ProjectKitchen/Bike-Generator/fotos/BikeGen_foto5.png

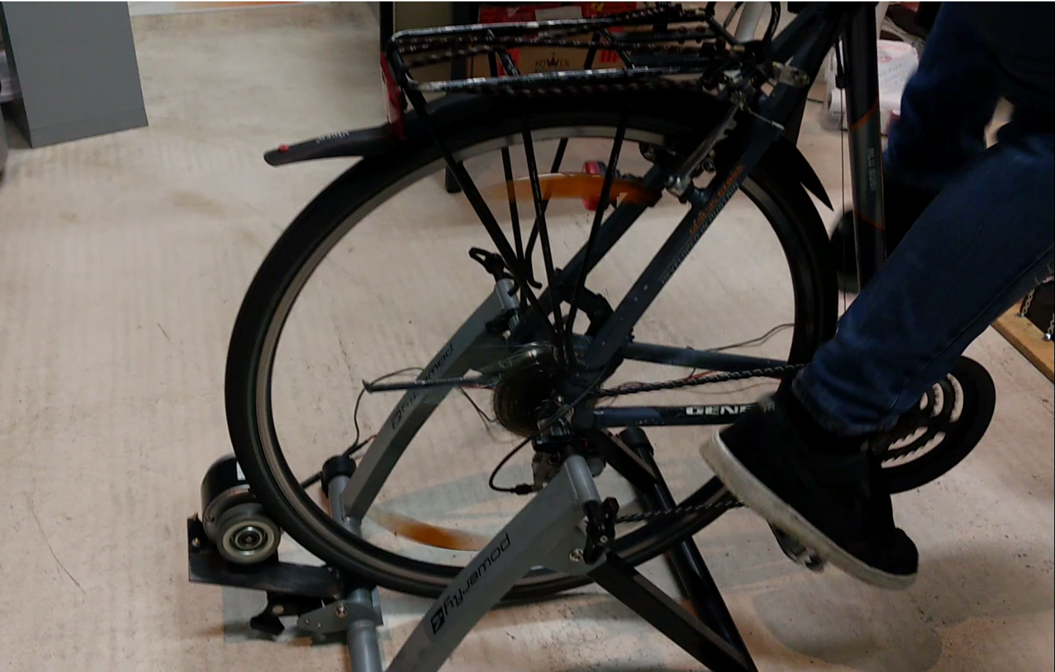
fotos/BikeGen_foto5.png
