ProjectKitchen/Bike-Generator/fotos/BikeGen_foto1.jpg

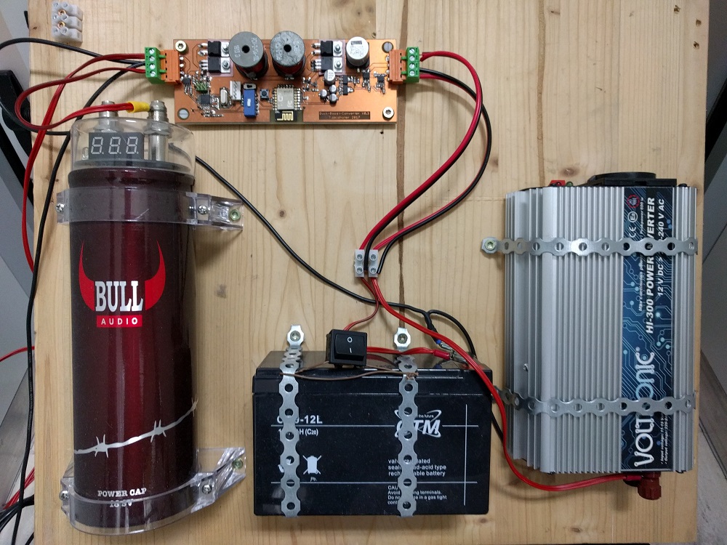
fotos/BikeGen_foto1.jpg
