ProjectKitchen/Bike-Generator/fotos/BikeGen_foto2.png

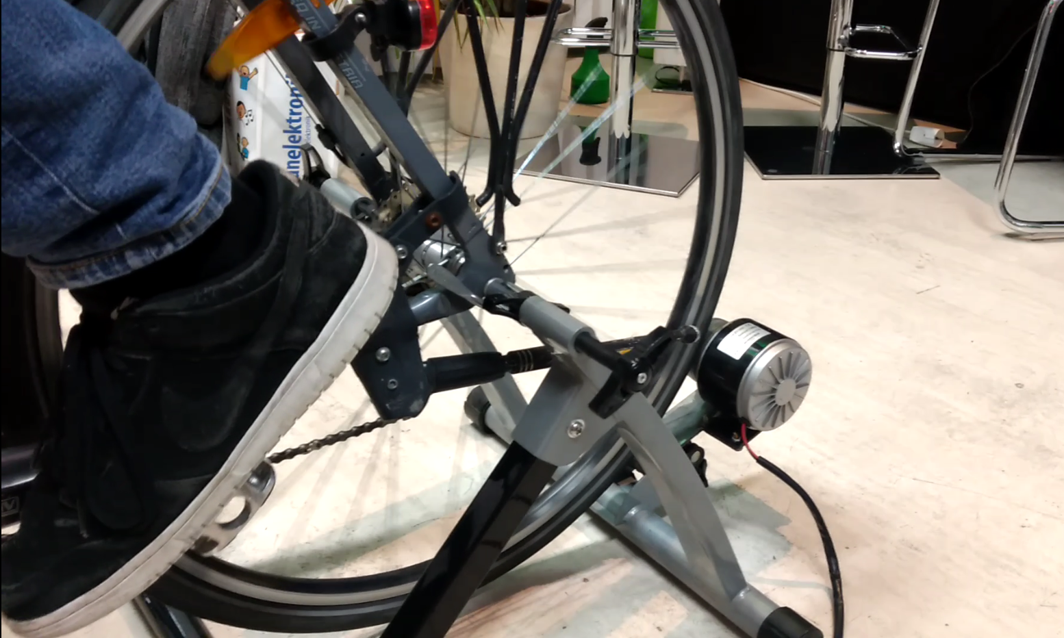
fotos/BikeGen_foto2.png
