ProjectKitchen/Bike-Generator/fotos/BikeGen_foto3.png

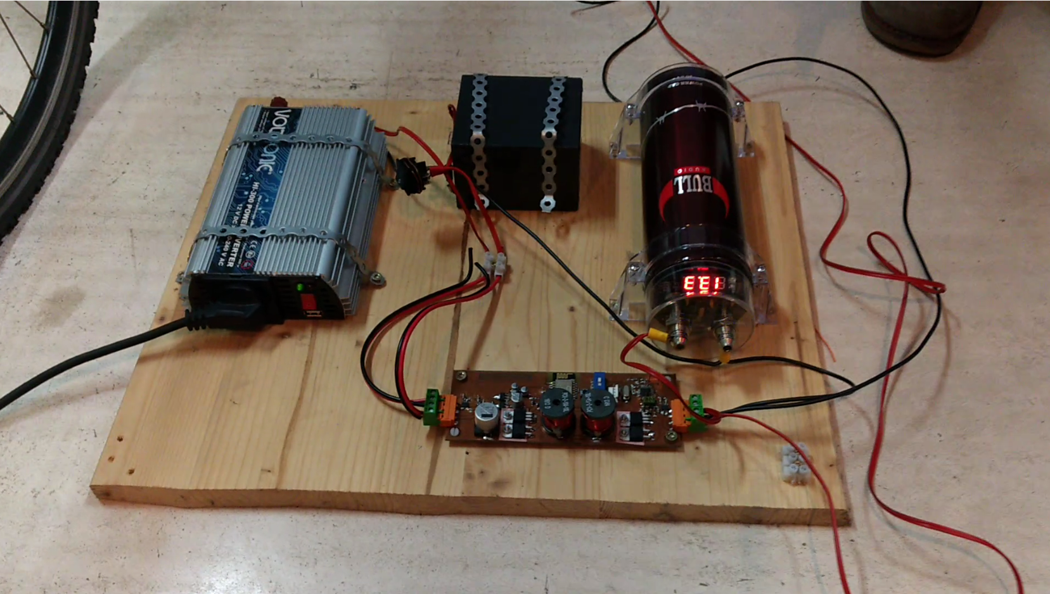
fotos/BikeGen_foto3.png
