ProjectKitchen/Bike-Generator/fotos/BikeGen_foto4.png

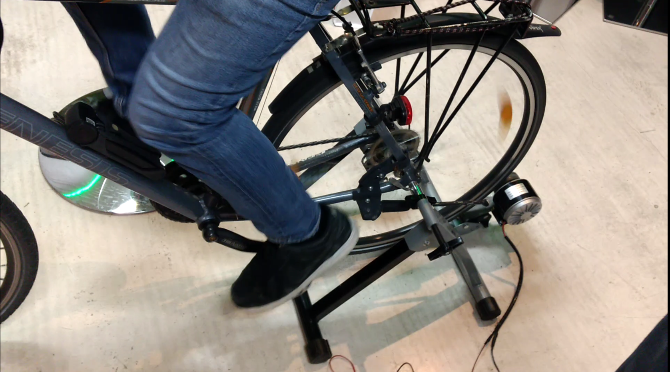
fotos/BikeGen_foto4.png
