ProjectKitchen/Bike-Generator/fotos/BikeGen_foto6.png

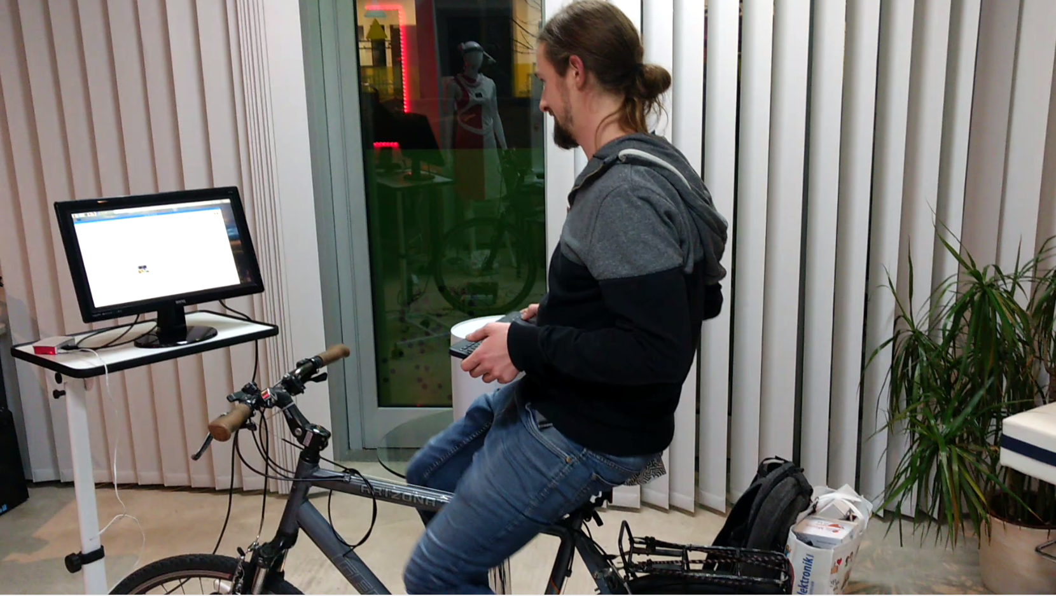
fotos/BikeGen_foto6.png
