ProjectKitchen/Bike-Generator/fotos/BikeGen_foto7.png

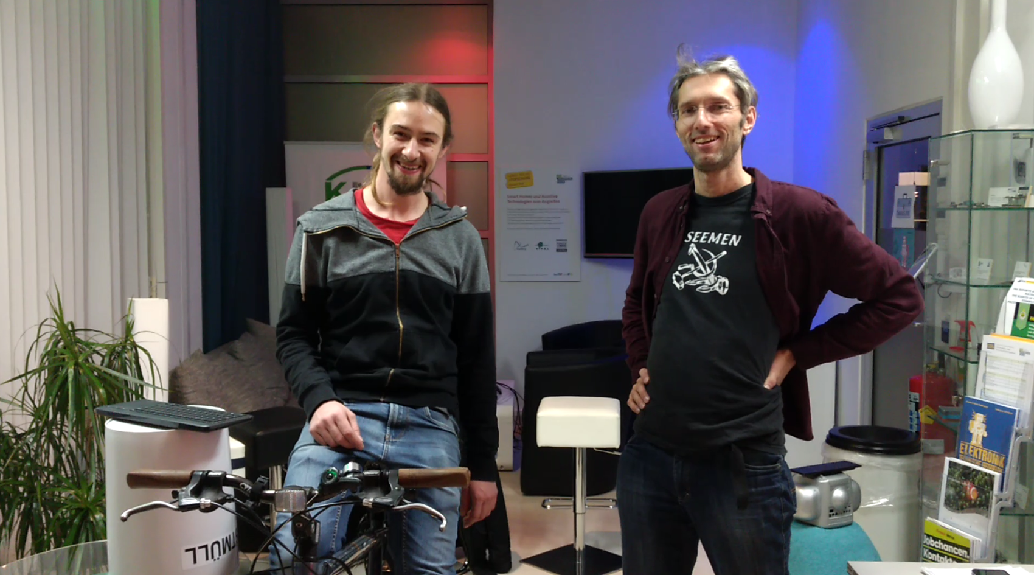
fotos/BikeGen_foto7.png
