ProjectKitchen/Bike-Generator/fotos/bull_2F_capacitor.jpg

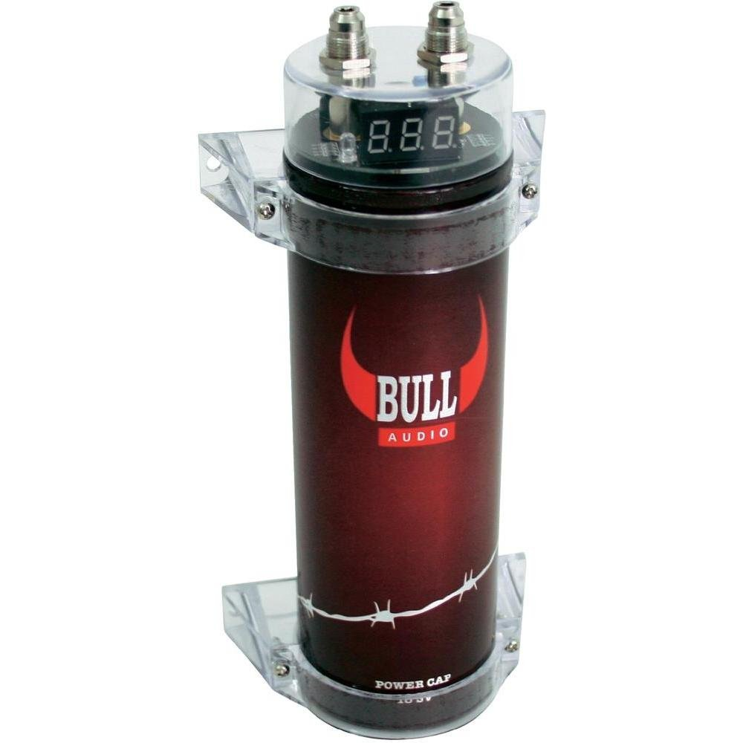
fotos/bull_2F_capacitor.jpg
