ProjectKitchen/Bike-Generator/fotos/MYZ016 ZY1016 Elektromotor DC 24V 200 W.jpg

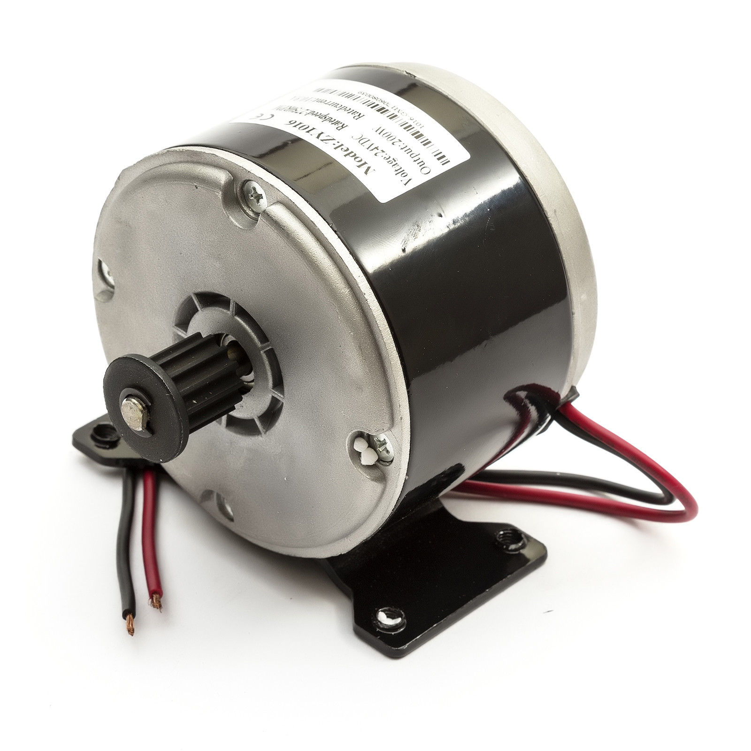
fotos/MYZ016 ZY1016 Elektromotor DC 24V 200 W.jpg
