ProjectKitchen/Bike-Generator/fotos/powerfly_magnetic_rollentrainer.jpg

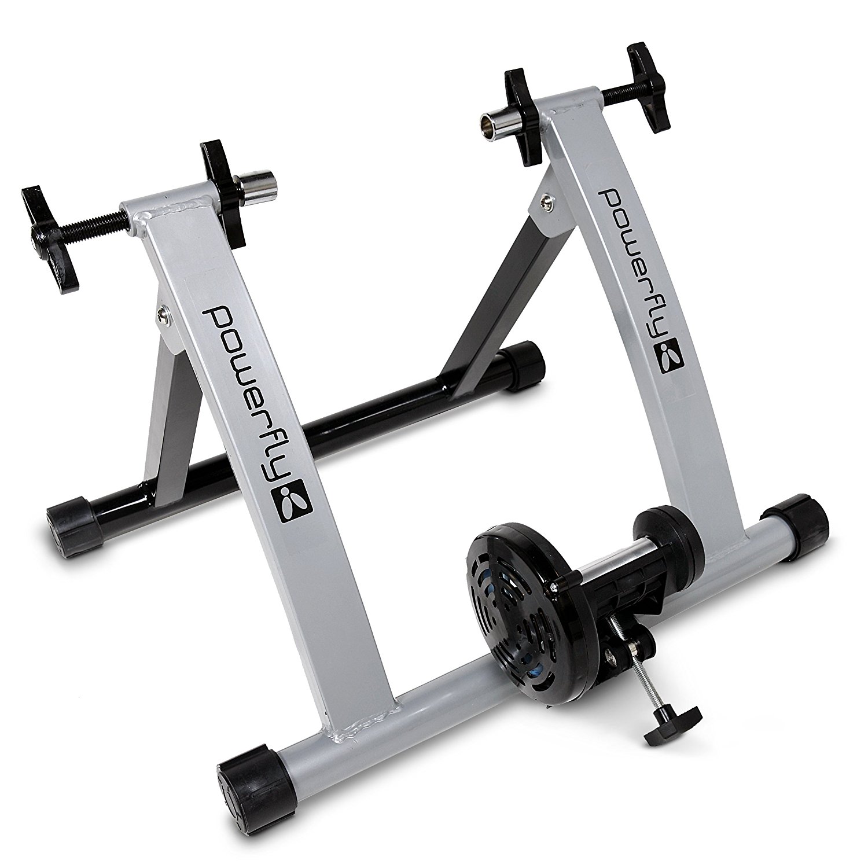
fotos/powerfly_magnetic_rollentrainer.jpg
