ProjectKitchen/Bike-Generator/fotos/voltronic_300W_inverterjpg.jpg

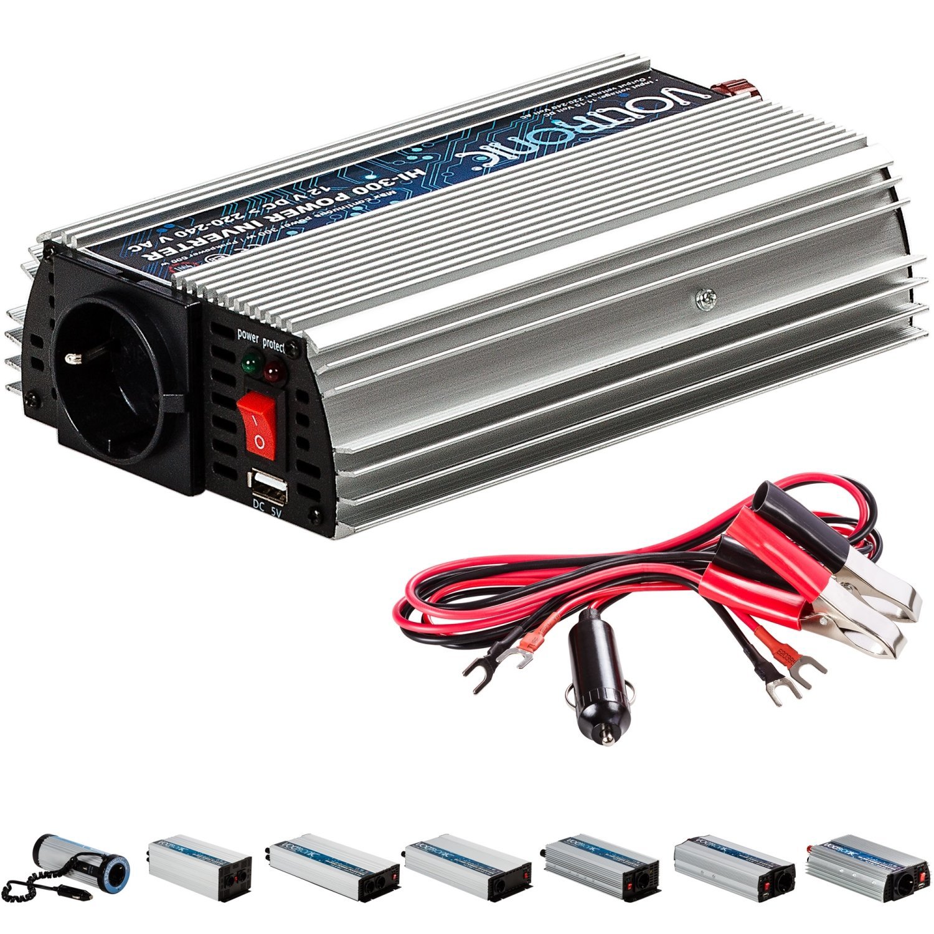
fotos/voltronic_300W_inverterjpg.jpg
