ProjectKitchen/Bike-Generator/BOM.txt

MYZ016 ZY1016 DC Motor 24V 200W (ebay)                      30 €
Bull 2F Capacitor               (amazon)                    29 €
Voltronic 300W Inverter         (amazon)                    35 €
Powerfly Magnetic Bike Trainer  (amazon)                    42 €
12V LeadScid Gel Battery                                    15 €
Components for buck/boost converter  (see bachelor paper)   58 €
wood, cables, etc.                                           5 €
                                                          ------
								                           214 €
