ProjectKitchen/Bike-Generator/PCB-Eagle/Final_Farnell_orderlist.xlsx

Sheet: Sheet1
Part Number | Quantity
1081224 | 4
1329624 | 3
1462952 | 1
1469076 | 1
1715486 | 1
1759195 | 2
1759265 | 6
2320018 | 1
2395958 | 1
2447553 | 5
2447654 | 3
2464030 | 2
2527545 | 4
2543088 | 1
2611384 | 3
2611386 | 1
2630479 | 1
9406344 | 3
9778314 | 1
9803351 | 2
9846530 | 2

Sheet: Sheet2
Part Number | Quantity | Description
62X6560 | 1 | Raspberry Pi

Sheet: Sheet3
Part Number | Quantity | Description
62X6560 | 1 | Raspberry Pi
