ProjectKitchen/Bike-Generator/PCB-Eagle/partslist1 (tobis-PC's conflicted copy 2017-02-14).xlsx

Sheet: partslist_THT
Part | Value | Device | Package | Library | Price(1+) | Price(10+) | cheaper | link
AMMETER1 | ACS712ELCTR-20A-T | ACS712ELCTR-20A-T | SOIC127P600X175-8N | ACS712-20A_Farnell | 4.310 | 2.480 | 2.480 | http://at.farnell.com/allegro-microsystems/acs712elctr-20a-t/sensor-strom-20a-soic8-712/dp/1329624
AMMETER2 | ACS712ELCTR-20A-T | ACS712ELCTR-20A-T | SOIC127P600X175-8N | ACS712-20A_Farnell | 4.310 | 2.480 | 2.480 | http://at.farnell.com/allegro-microsystems/acs712elctr-20a-t/sensor-strom-20a-soic8-712/dp/1329624
AMMETER3 | ACS712ELCTR-20A-T | ACS712ELCTR-20A-T | SOIC127P600X175-8N | ACS712-20A_Farnell | 4.310 | 2.480 | 2.480 | http://at.farnell.com/allegro-microsystems/acs712elctr-20a-t/sensor-strom-20a-soic8-712/dp/1329624
BIKE_INPUT |  | PINHD-1X2 | 1X02 | pinhead | 0.170 | 0.153 | 0.153 | http://at.farnell.com/camdenboss/ctbp3051-2/klemmenblock-wire-to-board-2pos/dp/2527545
C1 | 22pF | C-EU025-024X044 | C025-024X044 | rcl |  | 0.206 | 0.206 | http://at.farnell.com/vishay/k220j15c0gf53l2/kond-mlcc-c0g-np0-22pf-50v-radial/dp/1141760
C2 | 22pF | C-EU025-024X044 | C025-024X044 | rcl |  | 0.206 | 0.206 | http://at.farnell.com/vishay/k220j15c0gf53l2/kond-mlcc-c0g-np0-22pf-50v-radial/dp/1141760
C3 | 1000uF | CPOL-EUE5-10,5 | E5-10,5 | rcl |  | 0.603 | 0.603 | http://at.farnell.com/panasonic-electronic-components/eca-1ehg102/kondensator-alu-elko-1000uf-25v/dp/1848543
C4 | 22uF | CPOL-EUE2-5 | E2-5 | rcl | 0.050 |  | 0.050 | http://at.farnell.com/multicomp/mcgpr16v226m5x11/alu-elko-22uf-16v-radial/dp/9451064
C5 | 22uF | CPOL-EUE2-5 | E2-5 | rcl | 0.050 |  | 0.050 | http://at.farnell.com/multicomp/mcgpr16v226m5x11/alu-elko-22uf-16v-radial/dp/9451064
C6 | 1nF | C-EU025-024X044 | C025-024X044 | rcl |  | 0.038 | 0.038 | http://at.farnell.com/multicomp/mcbu5102k5/kondensator-mlcc-y5p-1nf-50v-radial/dp/9411780
C7 | 100nF | C-EU025-024X044 | C025-024X044 | rcl |  | 0.073 | 0.073 | http://at.farnell.com/vishay/k104k15x7rf53l2/kondensator-mlcc-x7r-100nf-50v/dp/1141775
C8 | 100nF | C-EU025-025X050 | C025-025X050 | rcl |  | 0.073 | 0.073 | http://at.farnell.com/vishay/k104k15x7rf53l2/kondensator-mlcc-x7r-100nf-50v/dp/1141775
C9 | 1nF | C-EU025-024X044 | C025-024X044 | rcl |  | 0.038 | 0.038 | http://at.farnell.com/multicomp/mcbu5102k5/kondensator-mlcc-y5p-1nf-50v-radial/dp/9411780
C10 | 1nF | C-EU025-024X044 | C025-024X044 | rcl |  | 0.038 | 0.038 | http://at.farnell.com/multicomp/mcbu5102k5/kondensator-mlcc-y5p-1nf-50v-radial/dp/9411780
C11 | 100nF | C-EU025-024X044 | C025-024X044 | rcl |  | 0.073 | 0.073 | http://at.farnell.com/vishay/k104k15x7rf53l2/kondensator-mlcc-x7r-100nf-50v/dp/1141775
C12 | 22uF | CPOL-EUE2-5 | E2-5 | rcl | 0.050 |  | 0.050 | http://at.farnell.com/multicomp/mcgpr16v226m5x11/alu-elko-22uf-16v-radial/dp/9451064
C14 | 220uF | CPOL-EUE3.5-8 | E3,5-8 | rcl | 0.119 |  | 0.119 | http://at.farnell.com/multicomp/mcgpr25v227m8x11/alu-elko-220uf-25v-radial/dp/9451196
D1 |  | STPS1045 | TO220AC | stps1045_own | 0.774 |  | 0.774 | http://at.farnell.com/stmicroelectronics/stps1045d/schottky-diode-10a-45v/dp/9803351?exaMfpn=true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
D2 |  | STPS1045 | TO220AC | stps1045_own | 0.774 |  | 0.774 | http://at.farnell.com/stmicroelectronics/stps1045d/schottky-diode-10a-45v/dp/9803351?exaMfpn=true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
D3 | GPA1603 | DIODE-C221B1A | C221B1A | diode | ??? |  | ???
EXTERNAL_CAP |  | PINHD-1X2 | 1X02 | pinhead | 0.170 | 0.153 | 0.153 | http://at.farnell.com/camdenboss/ctbp3051-2/klemmenblock-wire-to-board-2pos/dp/2527545
IC1 | MEGA8-P | MEGA8-P | DIL28-3 | atmel | 3.330 |  | 3.330 | http://at.farnell.com/atmel/atmega328p-pu/mcu-8bit-avr-32k-flash-28pdip/dp/1715487
IC2 | LD117AV33 | LD117AV33 | TO220L1 | v-reg | 0.397 |  | 0.397 | http://at.farnell.com/stmicroelectronics/ld1117v33c/spannungsregler/dp/1703357
IC3 | LD117AV50 | LD117AV50 | TO220L1 | v-reg | 0.624 |  | 0.624 | http://at.farnell.com/stmicroelectronics/ld1117v50/v-reg-ldo-5-0v-1117-to220-3/dp/1087175
L1 |  | L-EUTJ4-U2 | TJ4-U2 | rcl | 5.220 |  | 5.220 | http://at.farnell.com/coilcraft/pcv-2-104-10l/leistungsinduktivit-t-100uh-10/dp/2457690?exaMfpn=true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
L2 |  | L-EUTJ4-U2 | TJ4-U2 | rcl | 5.220 |  | 5.220 | or | http://at.farnell.com/coilcraft/pcv-2-184-10l/leistungsinduktivit-t-180uh-8a/dp/2457692?exaMfpn=true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
Q2 | 16Mhz | CRYSTALHC49U70 | HC49U70 | crystal | 0.182 |  | 0.182 | http://at.farnell.com/qantek-technology-corporation/qcl16-0000f18b23b/quarz-16mhz-18pf-hc-49us/dp/2508458
R1 | 10k Ohm | R-EU_0207/10 | 0207/10 | resistor |  | 0.0317 | 0.032 | http://at.farnell.com/te-connectivity/cfr25j10k/kohleschichtwiderstand-10k-0-33w/dp/2329609
R2 | 1kR | R-EU_0207/10 | 0207/10 | resistor |  | 0.0492 | 0.049 | http://at.farnell.com/te-connectivity/lr1f1k0/metallschichtwiderstand-1k0-0/dp/2330035
R3 | 390R | R-EU_0207/10 | 0207/10 | resistor |  | 0.0554 | 0.055 | http://at.farnell.com/multicomp/mcmf006ff3900a50/metallschichtwiderstand-390r-1/dp/2401742
R4 | 1k R | R-EU_0207/10 | 0207/10 | resistor |  | 0.0492 | 0.049 | http://at.farnell.com/te-connectivity/lr1f1k0/metallschichtwiderstand-1k0-0/dp/2330035
R5 | 390R | R-EU_0207/10 | 0207/10 | resistor |  | 0.0554 | 0.055 | http://at.farnell.com/multicomp/mcmf006ff3900a50/metallschichtwiderstand-390r-1/dp/2401742
R6 | 1k R | R-EU_0207/10 | 0207/10 | resistor |  | 0.0492 | 0.049 | http://at.farnell.com/te-connectivity/lr1f1k0/metallschichtwiderstand-1k0-0/dp/2330035
R7 | 390R | R-EU_0207/10 | 0207/10 | resistor |  | 0.0554 | 0.055 | http://at.farnell.com/multicomp/mcmf006ff3900a50/metallschichtwiderstand-390r-1/dp/2401742
R9 | 10k Ohm | R-EU_0207/10 | 0207/10 | resistor |  | 0.0317 | 0.032 | http://at.farnell.com/te-connectivity/cfr25j10k/kohleschichtwiderstand-10k-0-33w/dp/2329609
T1 | SUP65P06-20 | SUP65P06-20 | TO220 | transistor-fet | 1.13 |  | 1.130 | http://at.farnell.com/fairchild-semiconductor/fqp27p06/mosfet-p-kanal-60v-27a-to-220/dp/9846530
T2 | SUP65P06-20 | SUP65P06-20 | TO220 | transistor-fet | 1.13 |  | 1.130 | http://at.farnell.com/fairchild-semiconductor/fqp27p06/mosfet-p-kanal-60v-27a-to-220/dp/9846530
T3 | BC33725BU | BC337-25-NPN-TO92-CBE | TO92-CBE | transistor |  | 0.173 | 0.173 | http://at.farnell.com/fairchild-semiconductor/bc33725bu/transistor-npn-45v-to-92-3-straight/dp/2453781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
T4 | BC33725BU | BC337-25-NPN-TO92-CBE | TO92-CBE | transistor |  | 0.173 | 0.173 | http://at.farnell.com/fairchild-semiconductor/bc33725bu/transistor-npn-45v-to-92-3-straight/dp/2453781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
T5 | BC32740TA | BC327-40 | TO92-EBC | transistor-pnp |  | 0.077 | 0.077 | http://at.farnell.com/fairchild-semiconductor/bc32740ta/transistor-bipolar-pnp-45v-to/dp/2453778
T6 | BC33725BU | BC337-25-NPN-TO92-CBE | TO92-CBE | transistor |  | 0.173 | 0.173 | http://at.farnell.com/fairchild-semiconductor/bc33725bu/transistor-npn-45v-to-92-3-straight/dp/2453781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
T7 | BC33725BU | BC337-25-NPN-TO92-CBE | TO92-CBE | transistor |  | 0.173 | 0.173 | http://at.farnell.com/fairchild-semiconductor/bc33725bu/transistor-npn-45v-to-92-3-straight/dp/2453781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
T8 | BC32740TA | BC327-40 | TO92-EBC | transistor-pnp |  | 0.077 | 0.077 | http://at.farnell.com/fairchild-semiconductor/bc32740ta/transistor-bipolar-pnp-45v-to/dp/2453778
TO_BATTERY |  | PINHD-1X2 | 1X02 | pinhead | 0.170 | 0.153 | 0.153 | http://at.farnell.com/camdenboss/ctbp3051-2/klemmenblock-wire-to-board-2pos/dp/2527545
TO_RECTIFIER |  | PINHD-1X2 | 1X02 | pinhead | 0.170 | 0.153 | 0.153 | http://at.farnell.com/camdenboss/ctbp3051-2/klemmenblock-wire-to-board-2pos/dp/2527545
U$1 | JS202011CQN-DPDT | JS202011CQN-DPDT | 2X3_SWITCH | Library_TW | 0.394 |  | 0.394 | http://at.farnell.com/c-k-components/js202011cqn/schalter-dpdt-0-6a-6vdc-tht/dp/2320018?ost=JS202011CQN-DPDT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
U$2 | SPC21205-4PDT | SPC21205-4PDT | 2X6_SWITCH | Library_TW | 1.780 |  | 1.780 | http://at.farnell.com/multicomp/spc21205/schiebeschalter-4pdt-0-3a-125v/dp/2543088
U1 | ESP01 | ESP01 | ESP01 | esp8266modules | 6.490 |  | 6.490 | http://www.digikey.at/product-detail/en/sparkfun-electronics/WRL-13678/1568-1235-ND/5725944
U2 | ESP-07 or 12 | ESP12ESMD | ESP12E-SMD | esp8266modules |  |  | 0.000
USB-PROGRAMMER |  | PINHD-1X5 | 1X05 | pinhead | 0.128 |  | 0.128 | http://at.farnell.com/molex/22-23-2051/stecker-pin-5kont/dp/1462952
PCB-RAW_MATERIAL |  |  |  |  |  |  | 7.580 | http://at.farnell.com/kelan/141301/leiterplatte-fotopositivlack-100x160/dp/141301
 |  |  |  |  |  | Total: | 46.044

Sheet: parslist_SMD
Part | Value | Device | Package | Library | Price(1+) | Price(10+) | link
AMMETER1 | ACS712ELCTR-20A-T | ACS712ELCTR-20A-T | SOIC127P600X175-8N | ACS712-20A_Farnell
AMMETER2 | ACS712ELCTR-20A-T | ACS712ELCTR-20A-T | SOIC127P600X175-8N | ACS712-20A_Farnell
AMMETER3 | ACS712ELCTR-20A-T | ACS712ELCTR-20A-T | SOIC127P600X175-8N | ACS712-20A_Farnell
BIKE_INPUT |  | PINHD-1X2 | 1X02 | pinhead
C1 | 22pF | C-EU025-024X044 | C025-024X044 | rcl |  | 0.0049 | http://at.farnell.com/multicomp/mc0402n220j500ct/kondensator-mlcc-c0g-np0-22pf/dp/1758951
C2 | 22pF | C-EU025-024X044 | C025-024X044 | rcl |  | 0.0049 | http://at.farnell.com/multicomp/mc0402n220j500ct/kondensator-mlcc-c0g-np0-22pf/dp/1758951
C3 |  | CPOL-EUE3.5-8 | E3,5-8 | rcl
C4 | 22uF | CPOL-EUE1.8-4 | E1,8-4 | rcl
C5 | 22uF | CPOL-EUE1.8-4 | E1,8-4 | rcl
C6 | 1nF | C-EU025-024X044 | C025-024X044 | rcl |  | 0.0039 | http://at.farnell.com/multicomp/mc0402b102k500ct/kondensator-mlcc-x7r-1nf-50v-0402/dp/1758991
C7 | 100nF | C-EU025-024X044 | C025-024X044 | rcl |  | 0.0039 | http://at.farnell.com/multicomp/mc0402b104k100ct/kondensator-mlcc-x7r-0-1uf-10v/dp/2627343
C8 | 100nF | C-EU025-025X050 | C025-025X050 | rcl |  | 0.0039 | http://at.farnell.com/multicomp/mc0402b104k100ct/kondensator-mlcc-x7r-0-1uf-10v/dp/2627343
C9 | 1nF | C-EU025-024X044 | C025-024X044 | rcl |  | 0.0039 | http://at.farnell.com/multicomp/mc0402b102k500ct/kondensator-mlcc-x7r-1nf-50v-0402/dp/1758991
C10 | 1nF | C-EU025-024X044 | C025-024X044 | rcl |  | 0.0039 | http://at.farnell.com/multicomp/mc0402b102k500ct/kondensator-mlcc-x7r-1nf-50v-0402/dp/1758991
C11 | 100nF | C-EU025-024X044 | C025-024X044 | rcl |  | 0.0039 | http://at.farnell.com/multicomp/mc0402b104k100ct/kondensator-mlcc-x7r-0-1uf-10v/dp/2627343
C12 |  | CPOL-EUE3.5-8 | E3,5-8 | rcl
C14 |  | CPOL-EUE3.5-8 | E3,5-8 | rcl
D1 |  | STPS1045 | TO220AC | stps1045_own
D2 |  | STPS1045 | TO220AC | stps1045_own
D3 | GPA1603 | DIODE-C221B1A | C221B1A | diode
EXTERNAL_CAP |  | PINHD-1X2 | 1X02 | pinhead
IC1 | MEGA8-P | MEGA8-P | DIL28-3 | atmel | 2.79 |  | http://at.farnell.com/atmel/atmega328p-au/mcu-8bit-avr-32k-flash-32tqfp/dp/1715486
IC2 | LD117AV33 | LD117AV33 | TO220L1 | v-reg
IC3 | LD117AV50 | LD117AV50 | TO220L1 | v-reg
L1 |  | L-EUTJ4-U2 | TJ4-U2 | rcl
L2 |  | L-EUTJ4-U2 | TJ4-U2 | rcl
Q2 | 16Mhz | CRYSTALHC49U70 | HC49U70 | crystal | 0.192 |  | http://at.farnell.com/multicomp/mcrsd16000f183000rr/crystal-16mhz-18pf-hc49-us-smd/dp/2395958
R1 | 10k Ohm | R-EU_0207/10 | 0207/10 | resistor |  | 0.0012 | http://at.farnell.com/multicomp/mc0063w0603110k/dickschichtwiderstand-10k-1-0/dp/9330399
R2 | 1kR | R-EU_0207/10 | 0207/10 | resistor |  | 0.0704 | http://at.farnell.com/te-connectivity/crgh1206f1k0/dickschichtwiderstand-1k-1-0-5w/dp/2332141
R3 | 390R | R-EU_0207/10 | 0207/10 | resistor |  | 0.0948 | http://at.farnell.com/te-connectivity/crgh1206f390r/dickschichtwiderstand-390r-1-0/dp/2332134
R4 | 1k R | R-EU_0207/10 | 0207/10 | resistor |  | 0.0704 | http://at.farnell.com/te-connectivity/crgh1206f1k0/dickschichtwiderstand-1k-1-0-5w/dp/2332141
R5 | 390R | R-EU_0207/10 | 0207/10 | resistor |  | 0.0948 | http://at.farnell.com/te-connectivity/crgh1206f390r/dickschichtwiderstand-390r-1-0/dp/2332134
R6 | 1k R | R-EU_0207/10 | 0207/10 | resistor |  | 0.0704 | http://at.farnell.com/te-connectivity/crgh1206f1k0/dickschichtwiderstand-1k-1-0-5w/dp/2332141
R7 | 390R | R-EU_0207/10 | 0207/10 | resistor |  | 0.0948 | http://at.farnell.com/te-connectivity/crgh1206f390r/dickschichtwiderstand-390r-1-0/dp/2332134
R9 | 10k Ohm | R-EU_0207/10 | 0207/10 | resistor |  | 0.0012 | http://at.farnell.com/multicomp/mc0063w0603110k/dickschichtwiderstand-10k-1-0/dp/9330399
T1 | SUP65P06-20 | SUP65P06-20 | TO220 | transistor-fet
T2 | SUP65P06-20 | SUP65P06-20 | TO220 | transistor-fet
T3 | BC337-25 | BC337-25-NPN-TO92-CBE | TO92-CBE | transistor
T4 | BC337-25 | BC337-25-NPN-TO92-CBE | TO92-CBE | transistor
T5 | BC327-40 | BC327-40 | TO92-EBC | transistor-pnp
T6 | BC337-25 | BC337-25-NPN-TO92-CBE | TO92-CBE | transistor
T7 | BC337-25 | BC337-25-NPN-TO92-CBE | TO92-CBE | transistor
T8 | BC327-40 | BC327-40 | TO92-EBC | transistor-pnp
TO_BATTERY |  | PINHD-1X2 | 1X02 | pinhead
TO_RECTIFIER |  | PINHD-1X2 | 1X02 | pinhead
U$1 | JS202011CQN-DPDT | JS202011CQN-DPDT | 2X3_SWITCH | Library_TW
U$2 | SPC21205-4PDT | SPC21205-4PDT | 2X6_SWITCH | Library_TW
U1 | ESP01 | ESP01 | ESP01 | esp8266modules
U2 | ESP-07 or 12 | ESP12ESMD | ESP12E-SMD | esp8266modules
USB-PROGRAMMER |  | PINHD-1X5 | 1X05 | pinhead

Sheet: Partslist_Final
Part | Value | Device | Package | Library | Price(1+) | Price(10+) | link
AMMETER1 | ACS712ELCTR-20A-T | ACS712ELCTR-20A-T | SOIC127P600X175-8N | ACS712-20A_Farnell | 4.31 | 2.48 | http://at.farnell.com/allegro-microsystems/acs712elctr-20a-t/sensor-strom-20a-soic8-712/dp/1329624
AMMETER2 | ACS712ELCTR-20A-T | ACS712ELCTR-20A-T | SOIC127P600X175-8N | ACS712-20A_Farnell | 4.31 | 2.48 | http://at.farnell.com/allegro-microsystems/acs712elctr-20a-t/sensor-strom-20a-soic8-712/dp/1329624
AMMETER3 | ACS712ELCTR-20A-T | ACS712ELCTR-20A-T | SOIC127P600X175-8N | ACS712-20A_Farnell | 4.31 | 2.48 | http://at.farnell.com/allegro-microsystems/acs712elctr-20a-t/sensor-strom-20a-soic8-712/dp/1329624
BIKE_INPUT |  | PINHD-1X2 | 1X02 | pinhead | 0.17 | 0.153 | http://at.farnell.com/camdenboss/ctbp3051-2/klemmenblock-wire-to-board-2pos/dp/2527545
C1 | 22pF | C-EU025-024X044 | C025-024X044 | rcl
C2 | 22pF | C-EU025-024X044 | C025-024X044 | rcl
C3 |  | CPOL-EUE3.5-8 | E3,5-8 | rcl
C4 | 22uF | CPOL-EUE1.8-4 | E1,8-4 | rcl
C5 | 22uF | CPOL-EUE1.8-4 | E1,8-4 | rcl
C6 | 1nF | C-EU025-024X044 | C025-024X044 | rcl
C7 | 100nF | C-EU025-024X044 | C025-024X044 | rcl
C8 | 100nF | C-EU025-025X050 | C025-025X050 | rcl
C9 | 1nF | C-EU025-024X044 | C025-024X044 | rcl
C10 | 1nF | C-EU025-024X044 | C025-024X044 | rcl
C11 | 100nF | C-EU025-024X044 | C025-024X044 | rcl
C12 |  | CPOL-EUE3.5-8 | E3,5-8 | rcl
C14 |  | CPOL-EUE3.5-8 | E3,5-8 | rcl
D1 |  | STPS1045 | TO220AC | stps1045_own
D2 |  | STPS1045 | TO220AC | stps1045_own
D3 | GPA1603 | DIODE-C221B1A | C221B1A | diode
EXTERNAL_CAP |  | PINHD-1X2 | 1X02 | pinhead
IC1 | MEGA8-P | MEGA8-P | DIL28-3 | atmel
IC2 | LD117AV33 | LD117AV33 | TO220L1 | v-reg
IC3 | LD117AV50 | LD117AV50 | TO220L1 | v-reg
L1 |  | L-EUTJ4-U2 | TJ4-U2 | rcl
L2 |  | L-EUTJ4-U2 | TJ4-U2 | rcl
Q2 | 16Mhz | CRYSTALHC49U70 | HC49U70 | crystal
R1 | 10k Ohm | R-EU_0204/7 | 0204/7 | rcl
R2 |  | R-EU_0207/10 | 0207/10 | resistor
R3 |  | R-EU_0207/10 | 0207/10 | resistor
R4 | 1k R | R-EU_0207/10 | 0207/10 | resistor
R5 | 330R | R-EU_0207/10 | 0207/10 | resistor
R6 | 1k R | R-EU_0207/10 | 0207/10 | resistor
R7 | 330R | R-EU_0207/10 | 0207/10 | resistor
R9 | 10k Ohm | R-EU_0204/7 | 0204/7 | rcl
T1 | SUP65P06-20 | SUP65P06-20 | TO220 | transistor-fet
T2 | SUP65P06-20 | SUP65P06-20 | TO220 | transistor-fet
T3 | BC337-25 | BC337-25-NPN-TO92-CBE | TO92-CBE | transistor
T4 | BC337-25 | BC337-25-NPN-TO92-CBE | TO92-CBE | transistor
T5 | BC327-40 | BC327-40 | TO92-EBC | transistor-pnp
T6 | BC337-25 | BC337-25-NPN-TO92-CBE | TO92-CBE | transistor
T7 | BC337-25 | BC337-25-NPN-TO92-CBE | TO92-CBE | transistor
T8 | BC327-40 | BC327-40 | TO92-EBC | transistor-pnp
TO_BATTERY |  | PINHD-1X2 | 1X02 | pinhead
TO_RECTIFIER |  | PINHD-1X2 | 1X02 | pinhead
U$1 | JS202011CQN-DPDT | JS202011CQN-DPDT | 2X3_SWITCH | Library_TW
U$2 | SPC21205-4PDT | SPC21205-4PDT | 2X6_SWITCH | Library_TW
U1 | ESP01 | ESP01 | ESP01 | esp8266modules
U2 | ESP-07 or 12 | ESP12ESMD | ESP12E-SMD | esp8266modules
USB-PROGRAMMER |  | PINHD-1X5 | 1X05 | pinhead
