ProjectKitchen/Bike-Generator/Guide to connecting the PCB.pdf

# tobiasweidhofer

# How to connect the board correctly

## Written By: Tobias Weidhofer

How to connect the board correctly

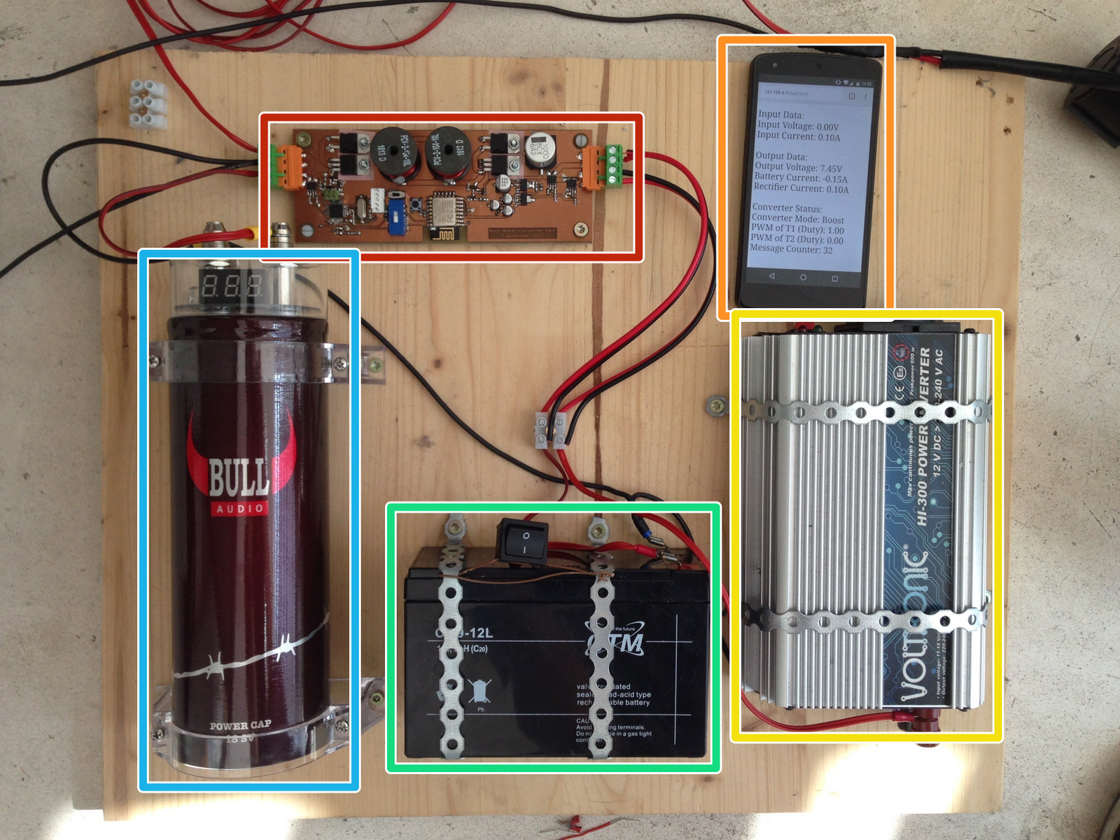
[picture p12: figure]

© 2017 | tobiasweidhofer.dozuki.com/ | Page 1 of 4

### TOOLS:

Electrical screwdriver (1)

### PARTS:

Pre-assembled board (1)

Step 1 — Overview of board

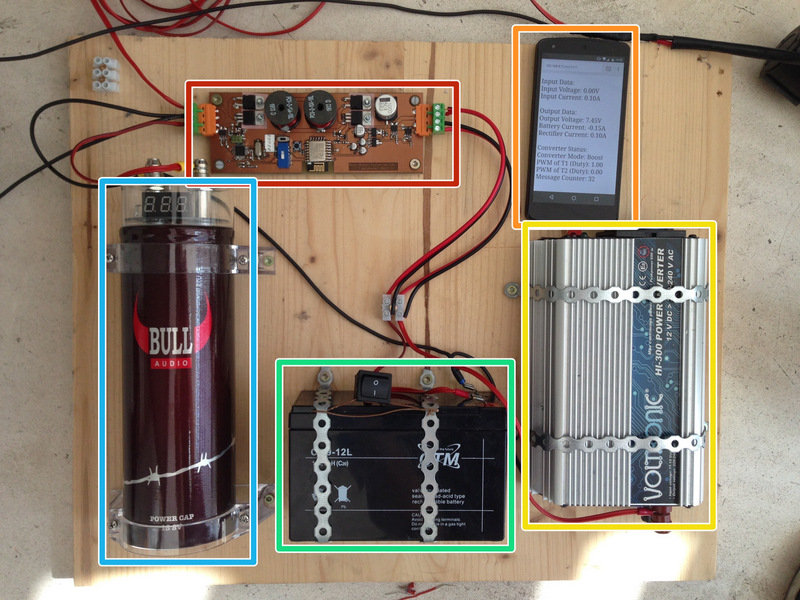
[picture p13: figure]

- The following components are on the board:
- The buck-boost-converter itsself.
- A device to display data (must be provided).

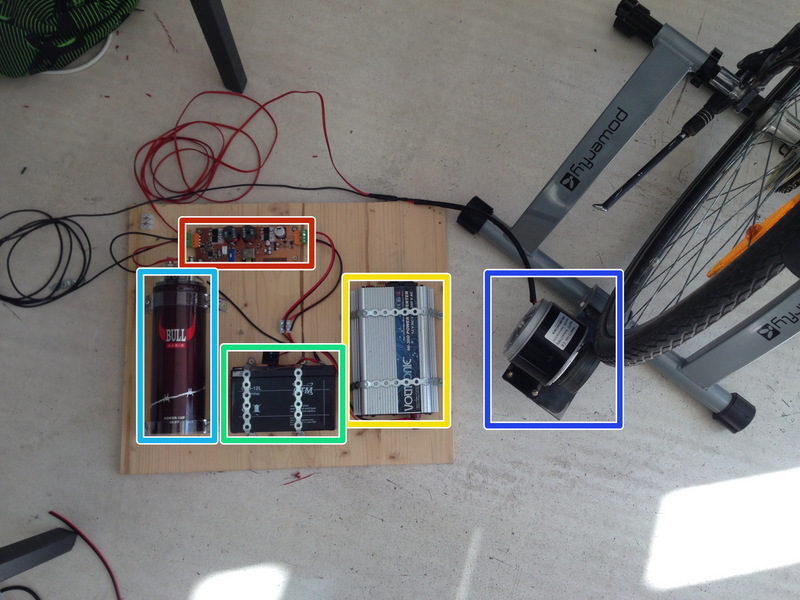
[picture p14: figure]

- A rectifier to allow the powering of 230V AC devices.
- A battery to store excess power.
- A capacitor to smooth the input voltage.
- The generator to power the board (bike not included, but needed).

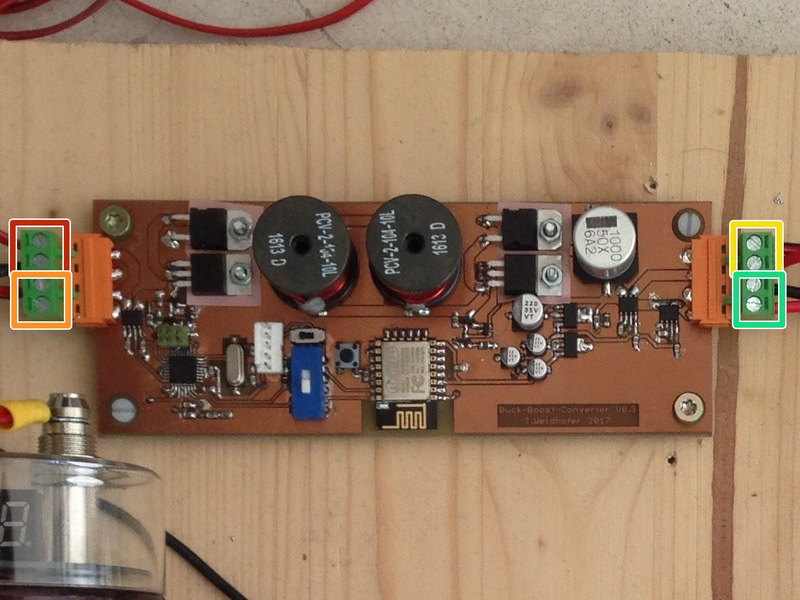
[picture p15: figure]

This document was last generated on 2017-12-04 08:00:43 AM.

Step 2 — Connections of PCB

All connectors have "+" on the left and "-" on the right when looked at from the cabling side!

The inputs are all on the left side of the PCB and the outputs are all on the right. these may not be exchanged!

- Connector to the generator
- Connector to the external capacitor
- Connector to the battery
- Connector to the rectifier

If no further programming is neccecary the device can now be accessed by connecting to the generated wifi signal and accessing the address:
http://192.168.4.1/read.html
