ProjectKitchen/Bike-Generator/PCB-Eagle/final_bottom.pdf

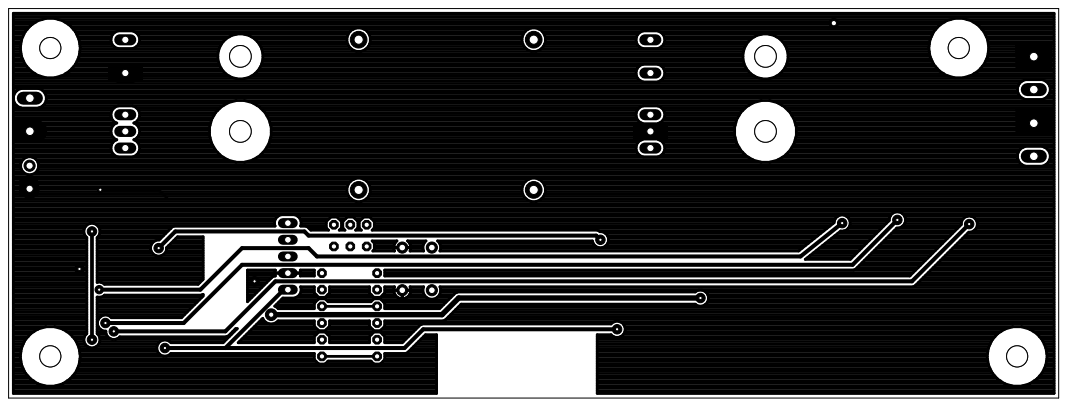
[picture p20: page 1]
