ProjectKitchen/Bike-Generator/PCB-Eagle/final_top.pdf

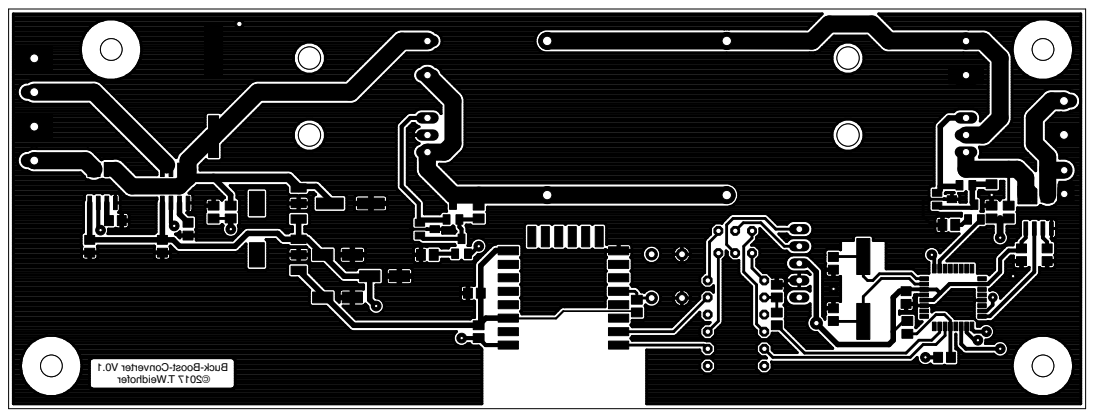
[picture p21: page 1]

1. 0Vr etr evno C-t sooB- kcuB
