ProjectKitchen/Bike-Generator/PCB-Eagle/backup_board.brd

## EAGLE design PCB-Eagle/backup_board.brd (2017-12-04)

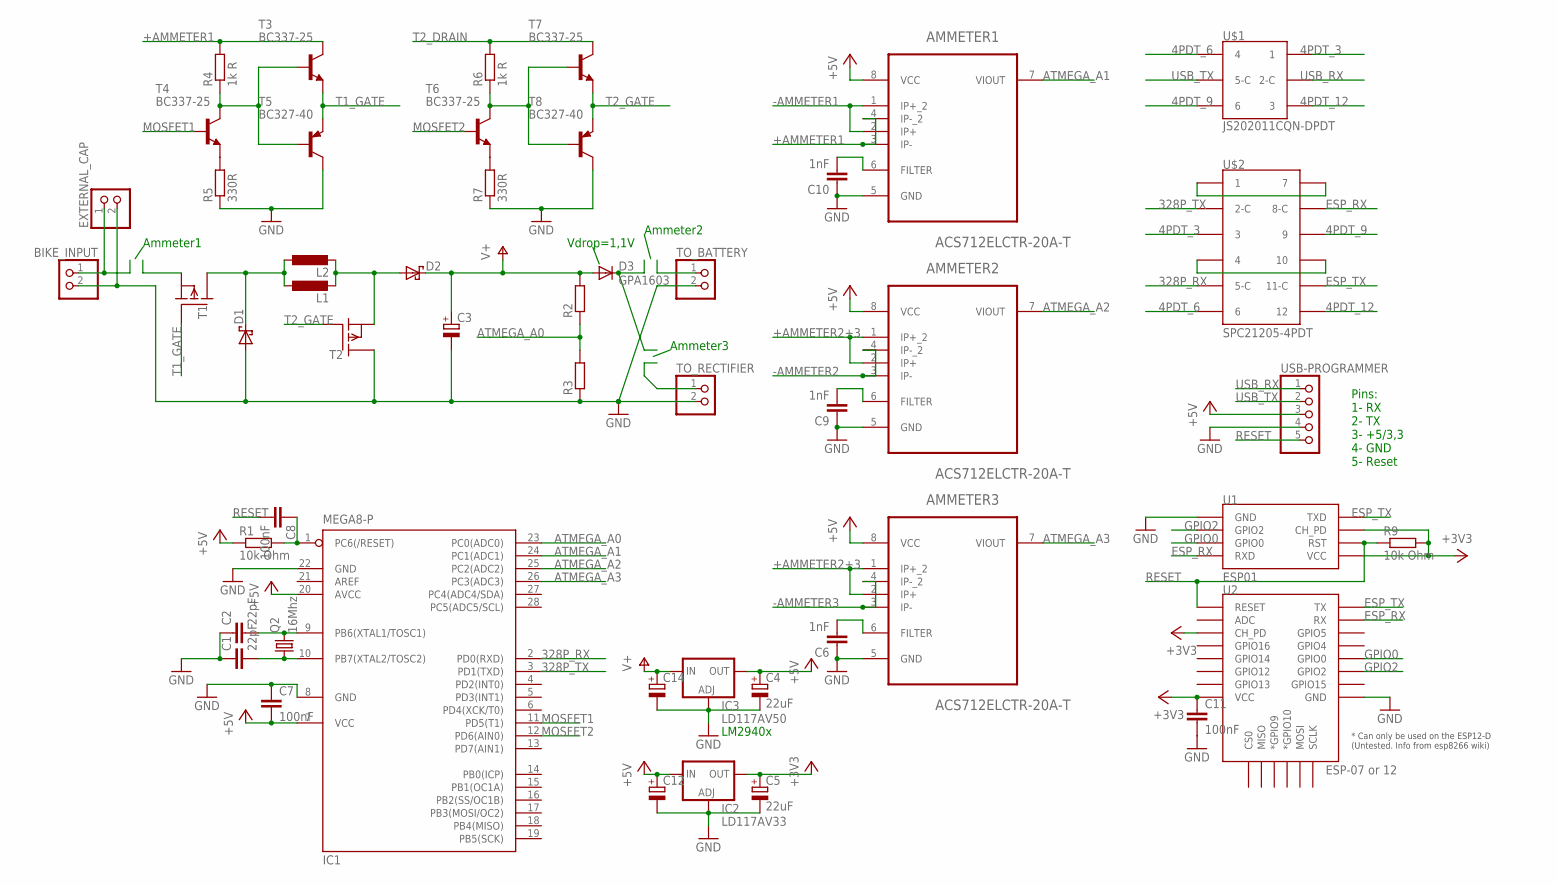
[picture p22: schematic backup_board.sch]

Parts:
AMMETER1, AMMETER2, AMMETER3: ACS712ELCTR-20A-T; SOIC127P600X175-8N
BIKE_INPUT: PINHD-1X2; 1X02
C1, C2: 22pF; C025-024X044
C3, C12, C14: CPOL-EUE3.5-8; E3,5-8
C4, C5: 22uF; E1,8-4
C6, C9, C10: 1nF; C025-024X044
C7, C11: 100nF; C025-024X044
C8: 100nF; C025-025X050
D1, D2: STPS1045; TO220AC
D3: GPA1603; C221B1A
EXTERNAL_CAP: PINHD-1X2; 1X02
IC1: MEGA8-P; DIL28-3
IC2: LD117AV33; TO220L1
IC3: LD117AV50; TO220L1
L1, L2: L-EUTJ4-U2; TJ4-U2
Q2: 16Mhz; HC49U70
R1, R9: 10k Ohm; 0204/7
R2, R3: R-EU_0207/10; 0207/10
R4, R6: 1k R; 0207/10
R5, R7: 330R; 0207/10
T1, T2: SUP65P06-20; TO220
T3, T4, T6, T7: BC337-25; TO92-CBE
T5, T8: BC327-40; TO92-EBC
TO_BATTERY: PINHD-1X2; 1X02
TO_RECTIFIER: PINHD-1X2; 1X02
U1: ESP01
U2: ESP-07 or 12; ESP12E-SMD
U$1: JS202011CQN-DPDT; 2X3_SWITCH
U$2: SPC21205-4PDT; 2X6_SWITCH
USB-PROGRAMMER: PINHD-1X5; 1X05

Connections:
4PDT_3: U$1.1, U$2.3
4PDT_6: U$1.4, U$2.6
4PDT_9: U$1.6, U$2.9
4PDT_12: U$1.3, U$2.12
328P_RX: IC1.2 (PD0(RXD)), U$2.5-C
328P_TX: IC1.3 (PD1(TXD)), U$2.2-C
+3V3: C5.+, C11.1, IC2.2 (OUT), R9.2, U1.CH_PD, U1.VCC, U2.CH_PD, U2.VCC
+5V: AMMETER1.8 (VCC), AMMETER2.8 (VCC), AMMETER3.8 (VCC), C4.+, C7.2, C12.+, IC1.7 (VCC), IC1.20 (AVCC), IC2.3 (IN), IC3.2 (OUT), R1.1, USB-PROGRAMMER.3
+AMMETER1: AMMETER1.3 (IP-), AMMETER1.4 (IP-_2), BIKE_INPUT.1, EXTERNAL_CAP.1, R4.2, T3.C
+AMMETER2+3: AMMETER2.1 (IP+_2), AMMETER2.2 (IP+), AMMETER3.1 (IP+_2), AMMETER3.2 (IP+), D3.C
-AMMETER1: AMMETER1.1 (IP+_2), AMMETER1.2 (IP+), T1.3 (S)
-AMMETER2: AMMETER2.3 (IP-), AMMETER2.4 (IP-_2), TO_BATTERY.1
-AMMETER3: AMMETER3.3 (IP-), AMMETER3.4 (IP-_2), TO_RECTIFIER.1
ATMEGA_A0: IC1.23 (PC0(ADC0)), R2.1, R3.2
ATMEGA_A1: AMMETER1.7 (VIOUT), IC1.24 (PC1(ADC1))
ATMEGA_A2: AMMETER2.7 (VIOUT), IC1.25 (PC2(ADC2))
ATMEGA_A3: AMMETER3.7 (VIOUT), IC1.26 (PC3(ADC3))
ESP_RX: U1.RX (RXD), U2.RXD0 (RX), U$2.8-C
ESP_TX: U1.TX (TXD), U2.TXD0 (TX), U$2.11-C
GND: AMMETER1.5 (GND), AMMETER2.5 (GND), AMMETER3.5 (GND), BIKE_INPUT.2, C1.1, C2.1, C3.-, C4.-, C5.-, C6.1, C7.1, C9.1, C10.1, C11.2, C12.-, C14.-, D1.A, EXTERNAL_CAP.2, IC1.8 (GND), IC1.22 (GND), IC2.1 (ADJ), IC3.1 (ADJ), R3.1, R5.1, R7.1, T2.2 (D), T5.C, T8.C, TO_BATTERY.2, TO_RECTIFIER.2, U1.GND, U2.GND, USB-PROGRAMMER.4
GPIO0: U1.GPIO0, U2.GPIO0
GPIO2: U1.GPIO2, U2.GPIO2
MOSFET1: IC1.11 (PD5(T1)), T4.B
MOSFET2: IC1.12 (PD6(AIN0)), T6.B
unnamed: C1.2, IC1.10 (PB7(XTAL2/TOSC2)), Q2.1
unnamed: C2.2, IC1.9 (PB6(XTAL1/TOSC1)), Q2.2
unnamed: U$2.4, U$2.10
unnamed: U$2.1, U$2.7
unnamed: C8.1, IC1.1 (PC6(/RESET)), R1.2
unnamed: R7.2, T6.E
unnamed: D1.C, L1.1, L2.1, T1.2 (D)
unnamed: R5.2, T4.E
unnamed: R6.1, T6.C, T7.B, T8.B
unnamed: R4.1, T3.B, T4.C, T5.B
unnamed: AMMETER3.6 (FILTER), C6.2
unnamed: AMMETER2.6 (FILTER), C9.2
unnamed: AMMETER1.6 (FILTER), C10.2
RESET: C8.2, R9.1, U1.RST, U2.RESET, USB-PROGRAMMER.5
T1_GATE: T1.1 (G), T3.E, T5.E
T2_DRAIN: D2.A, L1.2, L2.2, R6.2, T2.3 (S), T7.C
T2_GATE: T2.1 (G), T7.E, T8.E
USB_RX: U$1.2-C, USB-PROGRAMMER.1
USB_TX: U$1.5-C, USB-PROGRAMMER.2
V+: C3.+, C14.+, D2.C, D3.A, IC3.3 (IN), R2.2

Notes on the sheet:
Ammeter1
Ammeter2
Ammeter3
Vdrop=1,1V
LM2940x
Pins: 1- RX 2- TX 3- +5/3,3 4- GND 5- Reset

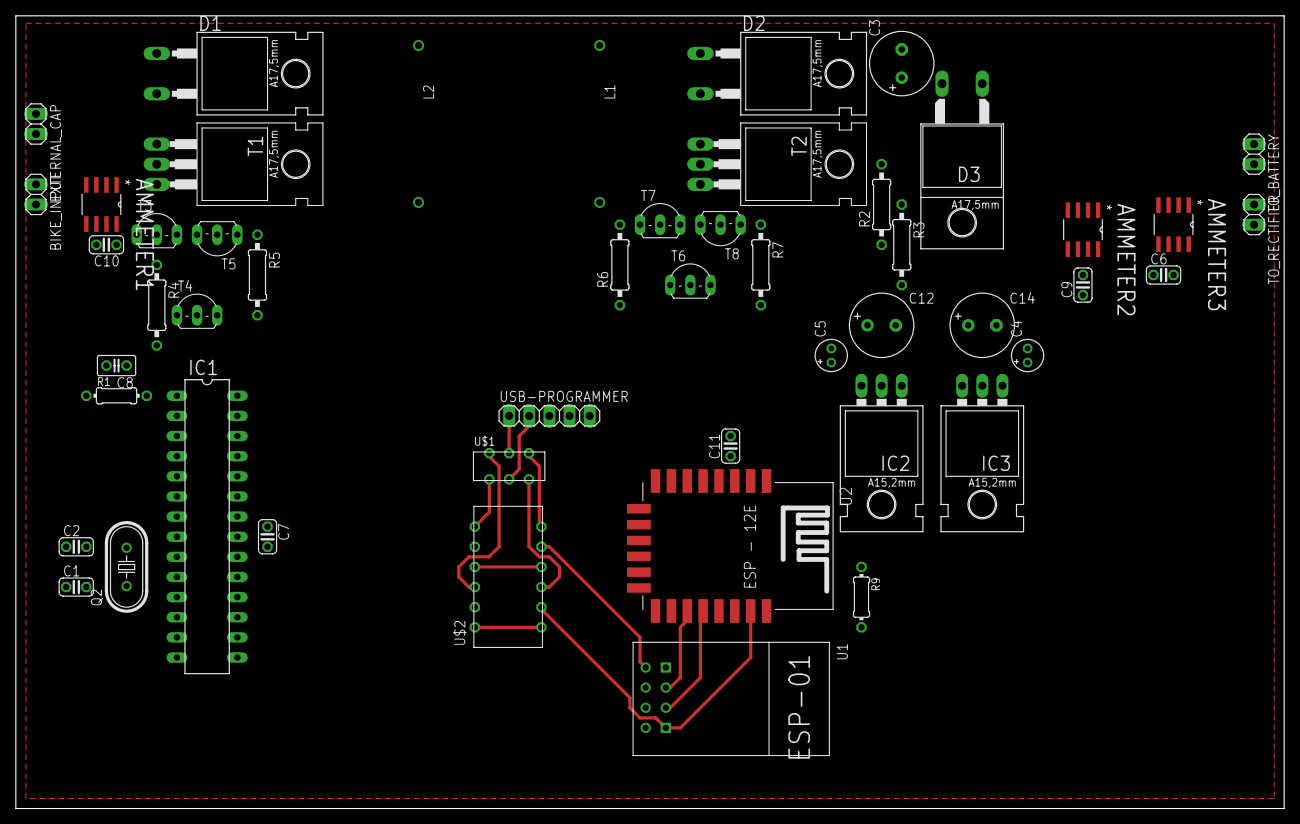
[picture p23: board backup_board.brd from above]

Board: 2 copper layers, 160.0 x 100.0 mm, 50 parts (0 on the bottom side), 44 nets.
