ProjectKitchen/Bike-Generator/(commit log)

2017-12-04 Added PCB files and Software
    [DRILEGEND.CFG, Final_Farnell_orderlist.xlsx, backup_board.brd, backup_board.sch, final.brd, final.sch, final_2_connectors.brd, final_2_connectors.sch]
2018-01-03 added fotos & bom
